Multianders1511/EGK_kredsl-b/EGK_kredsløb.kicad_pcb

## KiCad design EGK_kredsløb.kicad_pcb (2025-11-19)

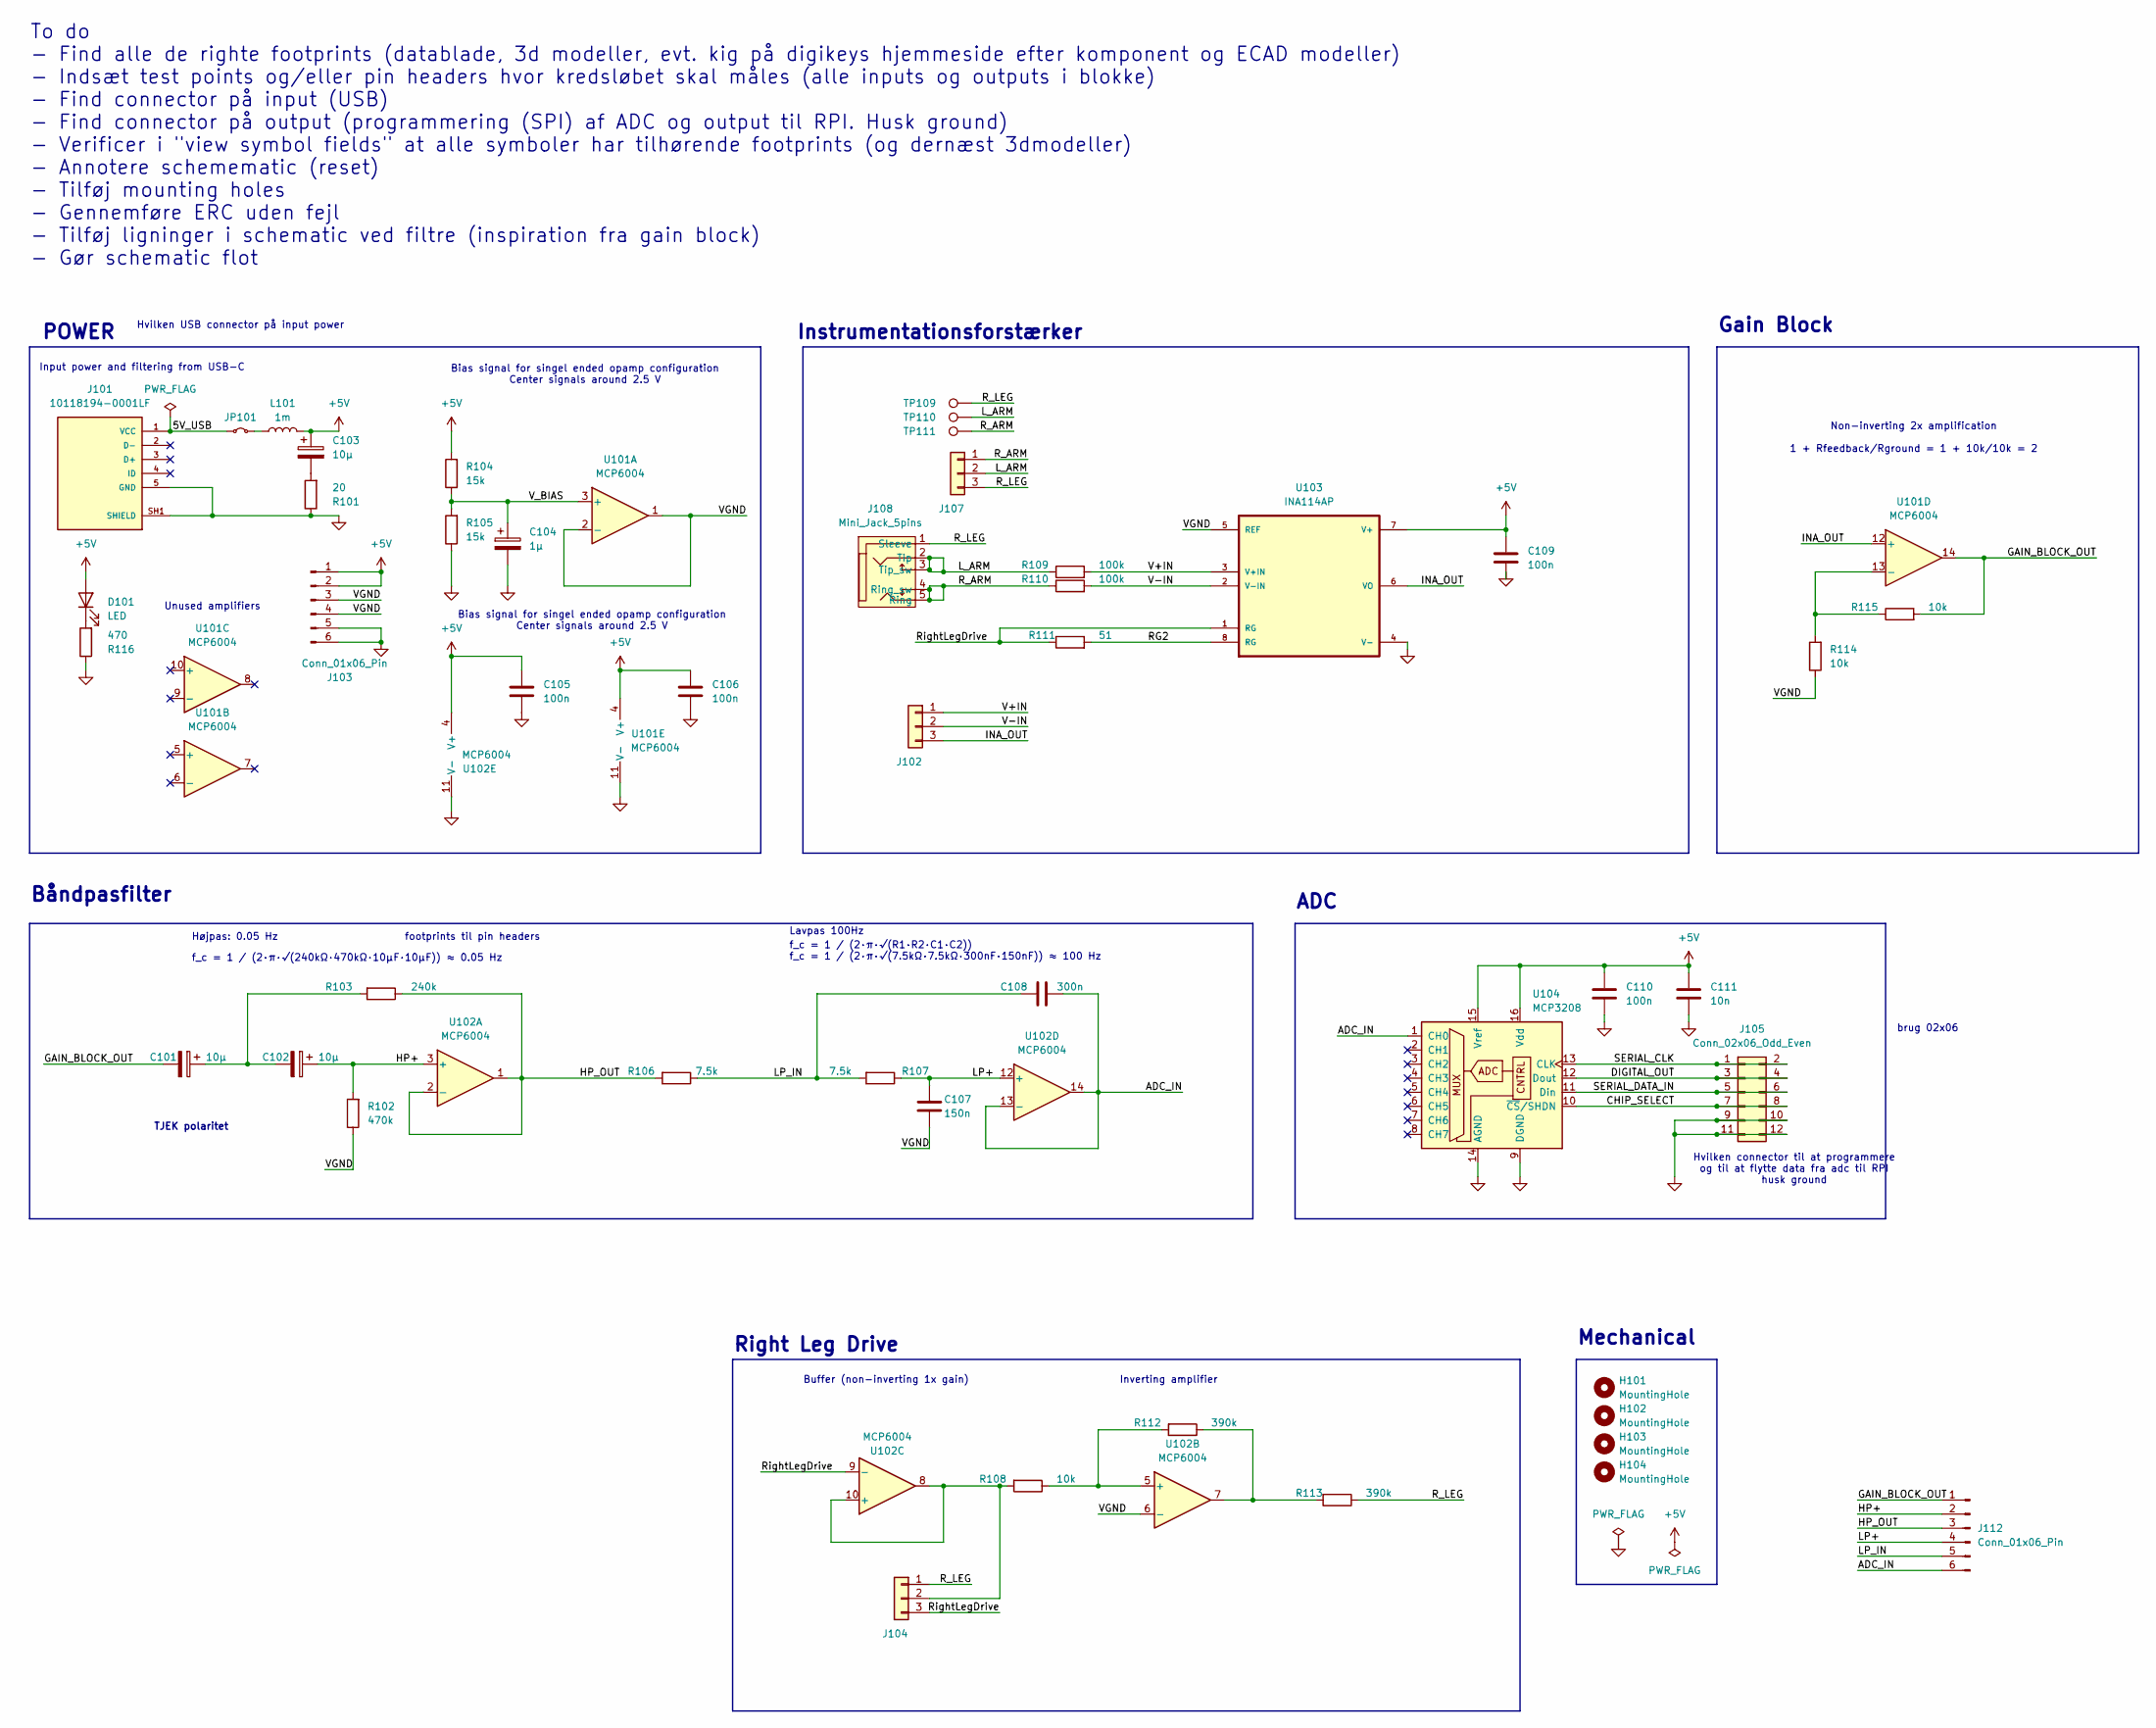
[picture p1: schematic EGK_kredsløb.kicad_sch]

Parts:
C101, C102, C103: 10μ; CP_Radial_D6.3mm_P2.50mm
C104: 1μ; CP_Radial_D6.3mm_P2.50mm
C105, C106, C109, C110: 100n; C_Rect_L7.0mm_W2.0mm_P5.00mm
C107: 150n; C_Rect_L7.0mm_W2.0mm_P5.00mm
C108: 300n; C_Rect_L7.0mm_W2.0mm_P5.00mm
C111: 10n; C_Rect_L7.0mm_W2.0mm_P5.00mm
D101: LED; LED_D5.0mm
H101, H102, H103, H104: MountingHole; MountingHole_3.2mm_M3_ISO7380
J101: 10118194-0001LF; AMPHENOL_10118194-0001LF; PARTREV D
J102, J104, J107: Conn_01x03; PinHeader_1x03_P2.54mm_Vertical
J103, J112: Conn_01x06_Pin; PinHeader_1x06_P2.54mm_Vertical
J105: Conn_02x06_Odd_Even; PinHeader_2x06_P2.54mm_Vertical
J108: Mini_Jack_5pins; mini_jack_5pins
JP101: Jumper_2_Small_Bridged; PinHeader_1x02_P2.54mm_Vertical
L101: 1m; L_Axial_L7.0mm_D3.3mm_P12.70mm_Horizontal_Fastron_MICC
R101: 20; R_Axial_DIN0207_L6.3mm_D2.5mm_P10.16mm_Horizontal
R102: 470k; R_Axial_DIN0207_L6.3mm_D2.5mm_P10.16mm_Horizontal
R103: 240k; R_Axial_DIN0207_L6.3mm_D2.5mm_P10.16mm_Horizontal
R104, R105: 15k; R_Axial_DIN0207_L6.3mm_D2.5mm_P10.16mm_Horizontal
R106, R107: 7.5k; R_Axial_DIN0207_L6.3mm_D2.5mm_P10.16mm_Horizontal
R108, R114, R115: 10k; R_Axial_DIN0207_L6.3mm_D2.5mm_P10.16mm_Horizontal
R109, R110: 100k; R_Axial_DIN0207_L6.3mm_D2.5mm_P10.16mm_Horizontal
R111: 51; R_Axial_DIN0207_L6.3mm_D2.5mm_P10.16mm_Horizontal
R112, R113: 390k; R_Axial_DIN0207_L6.3mm_D2.5mm_P10.16mm_Horizontal
R116: 470; R_Axial_DIN0207_L6.3mm_D2.5mm_P10.16mm_Horizontal
TP109, TP110, TP111: TestPoint; TestPoint_Pad_D3.0mm
U101, U102: MCP6004; DIP-14_W7.62mm_Socket_LongPads
U103: INA114AP; PDIP8; LCSC C38890
U104: MCP3208; DIP-16_W7.62mm_Socket_LongPads

Connections:
+5V: C103.1, C105.1, C106.1, C109.1, C110.1, C111.1, D101.2 (A), J103.1, J103.2, L101.2, R104.2, U101.4 (V+), U102.4 (V+), U103.7 (V+), U104.15 (Vref), U104.16 (Vdd)
/5V_USB: J101.1 (VCC), JP101.1 (A)
/ADC_IN: C108.2, J112.6, U102.13 (-), U102.14, U104.1 (CH0)
/CHIP_SELECT: J105.7, J105.8, U104.10 (~CS/SHDN)
/DIGITAL_OUT: J105.3, J105.4, U104.12 (Dout)
/GAIN_BLOCK_OUT: C101.2, J112.1, R115.2, U101.14
/HP+: C102.1, J112.2, R102.2, U102.3 (+)
/HP_OUT: J112.3, R103.1, R106.2, U102.1, U102.2 (-)
/INA_OUT: J102.3, U101.12 (+), U103.6 (VO)
/LP+: C107.2, J112.4, R107.1, U102.12 (+)
/LP_IN: C108.1, J112.5, R106.1, R107.2
/L_ARM: J107.2, J108.2 (Tip), J108.3 (Tip_sw), R109.1, TP110.1
/RG2: R111.2, U103.8 (RG)
/R_ARM: J107.1, J108.4 (Ring_sw), J108.5 (Ring), R110.1, TP111.1
/R_LEG: J104.1, J107.3, J108.1 (Sleeve), R113.1, TP109.1
/RightLegDrive: J104.3, R111.1, U102.9 (-), U103.1 (RG)
/SERIAL_CLK: J105.1, J105.2, U104.13 (CLK)
/SERIAL_DATA_IN: J105.5, J105.6, U104.11 (Din)
/V+IN: J102.1, R109.2, U103.3 (V+IN)
/V-IN: J102.2, R110.2, U103.2 (V-IN)
/VGND: C107.1, J103.3, J103.4, R102.1, R114.1, U101.1, U101.2 (-), U102.6 (-), U103.5 (REF)
/V_BIAS: C104.1, R104.1, R105.2, U101.3 (+)
GND: C104.2, C105.2, C106.2, C109.2, C110.2, C111.2, J101.5 (GND), J101.SH1 (SHIELD), J101.SH2 (SHIELD), J101.SH3 (SHIELD), J101.SH4 (SHIELD), J101.SH5 (SHIELD), J101.SH6 (SHIELD), J103.5, J103.6, J105.9, J105.10, J105.11, J105.12, R101.1, R105.1, R116.1, U101.11 (V-), U102.11 (V-), U103.4 (V-), U104.9 (DGND), U104.14 (AGND)
unnamed: C101.1, C102.2, R103.2
unnamed: C103.2, R101.2
unnamed: D101.1 (K), R116.2
unnamed: J104.2, R108.2, U102.8, U102.10 (+)
unnamed: JP101.2 (B), L101.1
unnamed: R112.1, R113.2, U102.7
unnamed: R114.2, R115.1, U101.13 (-)
unnamed: R108.1, R112.2, U102.5 (+)

Notes on the sheet:
Input power and filtering from USB-C
brug 02x06
footprints til pin headers
Gain Block
Buffer (non-inverting 1x gain)
Inverting amplifier
Non-inverting 2x amplification 1 + Rfeedback/Rground = 1 + 10k/10k = 2
Båndpasfilter
To do - Find alle de righte footprints (datablade, 3d modeller, evt. kig på digikeys hjemmeside efter komponent og ECAD modeller) - Indsæt test points og/eller pin headers hvor kredsløbet skal måles (alle inputs og outputs i blokke) - Find connector på input (USB) - Find connector på output (progra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
Bias signal for singel ended opamp configuration Center signals around 2.5 V
TJEK polaritet
Instrumentationsforstærker
Mechanical
f_c = 1 / (2·π·√(240kΩ·470kΩ·10µF·10µF)) ≈ 0.05 Hz
Right Leg Drive
Lavpas 100Hz
f_c = 1 / (2·π·√(R1·R2·C1·C2)) f_c = 1 / (2·π·√(7.5kΩ·7.5kΩ·300nF·150nF)) ≈ 100 Hz
Hvilken USB connector på input power
Højpas: 0.05 Hz
POWER
ADC
Hvilken connector til at programmere og til at flytte data fra adc til RPI husk ground
Unused amplifiers

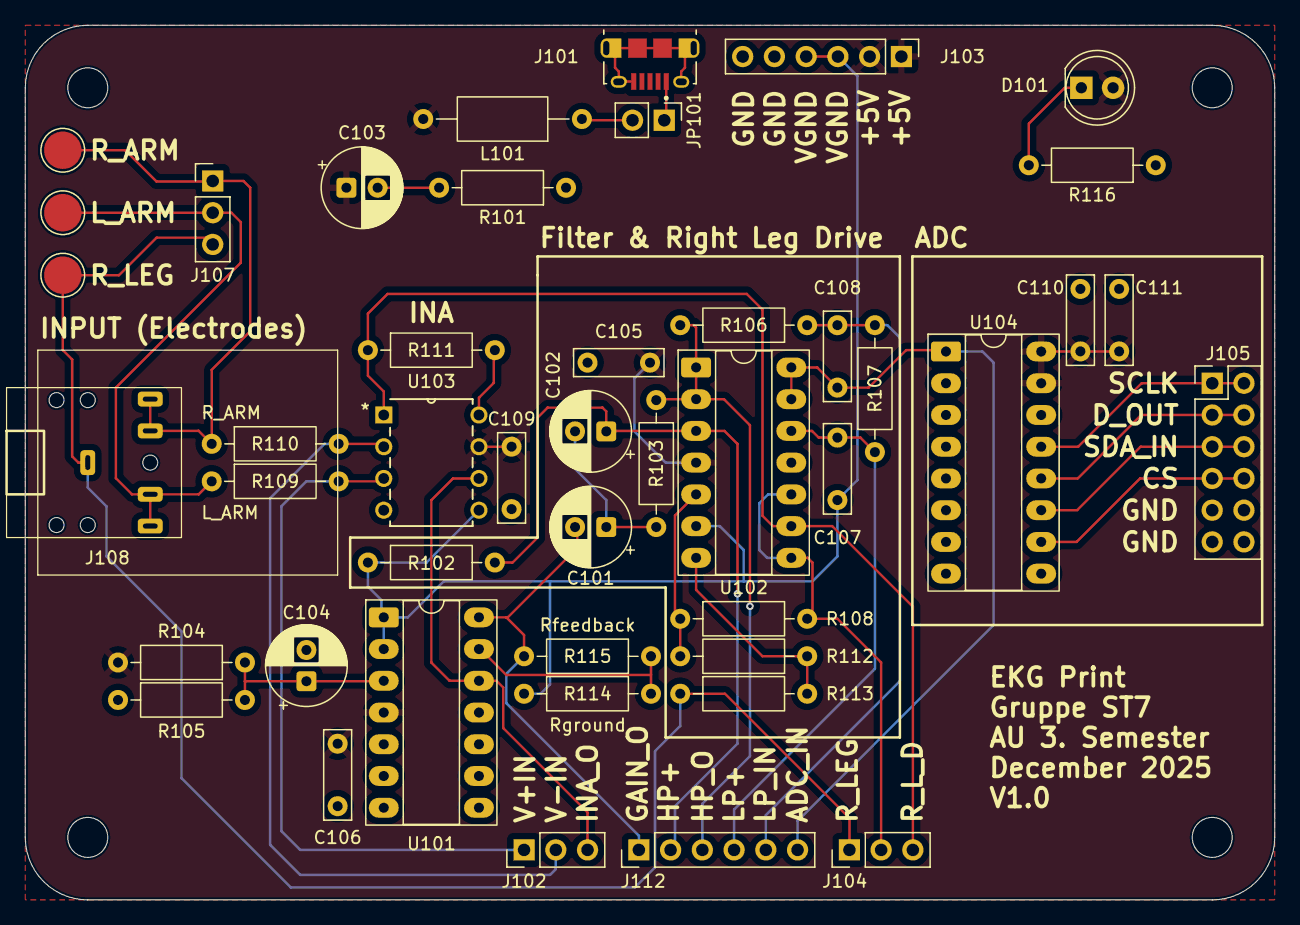
[picture p2: board EGK_kredsløb.kicad_pcb from above]

Board: 2 copper layers, 100.0 x 70.0 mm, 49 parts (0 on the bottom side), 31 nets.
