Multianders1511/EGK_kredsl-b/(commit log)

2025-11-14 finished schematic, missing AUX
    [EGK_kredsløb.kicad_pcb, EGK_kredsløb.kicad_sch]
2025-11-18 opdateret med micro-usb samt 3.5mm audio jack til elektroder
    [EGK_kredsløb.kicad_pcb, EGK_kredsløb.kicad_sch]
2025-11-18 ERC tjek, labels tilføjet til mini jack
    [EGK_kredsløb.kicad_sch]
2025-11-18 Add layout floorplan ready for routing
    [EGK_kredsløb.kicad_pcb, EGK_kredsløb.kicad_sch]
2025-11-18 3d-model til usb
    [EGK_kredsløb.kicad_pcb]
2025-11-19 opstart af routing
    [EGK_kredsløb.kicad_pcb]
2025-11-19 små ændringer med routing igen
    [EGK_kredsløb.kicad_pcb]
2025-11-19 routed pcb
    [EGK_kredsløb.kicad_pcb, EGK_kredsløb.kicad_sch]
